MillenniumMachines/UserMods/README.md

# Millennium Machines Community Modifications
Welcome to Millennium Machines Community Mods.

>**Note**: Most recent mods can be found in the Discord channel here: https://discord.com/channels/810620766756012072/1282257966266843136

This repository contains a curated list of modifications for all Millennium Machines. These mods are independently created by members of the community and are not supported in any way by the core Millennium Machines team.
