MillenniumMachines/UserMods/Milo-V1.5/README.md

# Millennium Machines Milo V1.5 Community Modifications

## AramcoPhil
  - [Ballscrew Upgrade](AramcoPhil/Ballscrew%20Upgrade/README.md)
  - [Endmill Organizer](AramcoPhil/Endmill%20Organizer/README.md)
  - [Noga Minicool Mounting Bracket](AramcoPhil/Noga%20Minicool%20Mounting%20Bracket/README.md)

## Bidi533
  - [VFD Mount](Bidi533/VFD%20Mount/README.md)

## Morfesto
  - [Anti-Backlash Nut Mod](Morfesto/Anti-Backlash%20Nut%20Mod/README.md)

## Mr-Rei
  - [80mm Spindle Mount](Mr-Rei/80mm%20Spindle%20Mount)

## seanmccully
  - [Igus Drylin Lead Screw](seanmccully/Igus%20Drylin%20Lead%20Screw/README.md)

## Techmorphic
  - [Parametric Z Plates](Techmorphic/FMJ%20Parametric%20Plates/)

## TheDeeperGrain
  - [Hearts of Iron (HOI)](TheDeeperGrain/Hearts%20of%20Iron%20%28HOI%29/README.md)

## TheUntitledGoose
  - [Ring Light Mod](TheUntitledGoose/Ring%20Light%20Mod/README.md)

## TinkerTailor
  - [80mm Spindle Mount](TinkerTailor/80mm%20Spindle%20Mount)
  - [Duet3 Mount](TinkerTailor/Duet3%20Mount)
  - [PS Bracket plus Cable Channels](TinkerTailor/PS%20Bracket%20plus%20Cable%20Channels/)
  - [SKR3 Mount](TinkerTailor/SKR3%20Mount)
