MillenniumMachines/UserMods/Milo-V1.5/AramcoPhil/Endmill Organizer/README.md

This is a remix of the GEN 2 Modular Drawer System (original Link: https://www.printables.com/model/427214-gen2-parts-drawers )

You'll need at least:

- 1x "Gen 2 Rail Double" from the original design
- 1x "Double Slim Drawer Case" from the original design
- 1x "Endmill ORganizer Drawer" from this directory
