MillenniumMachines/UserMods/Millennium-Milo-V1.5-MODS/Morfesto/Anti-Backlash Nut Mod/README.md

# Morfesto's Anti-Backlash Nut mod

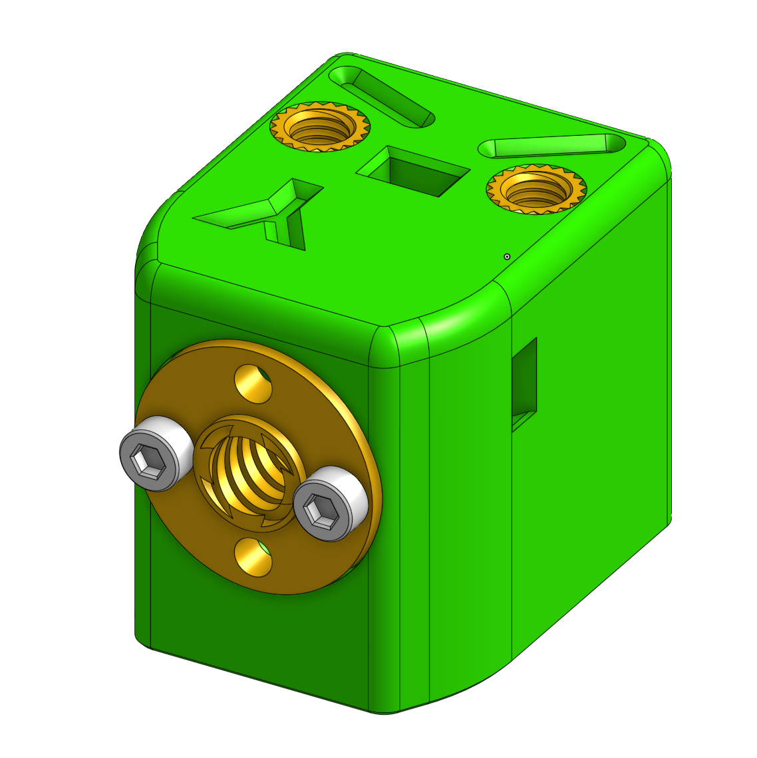
[picture p3: Millennium-Milo-V1.5-MODS/Morfesto/Anti-Backlash Nut Mod/images/iso_view.png]


This mod removes the M3 inserts that tend to bulge into the hole for the anti-backlash nut and replaces them with lock nuts. It also changes the M5 inserts to be inserted from the top so they can't be pulled out as easily.
<table>
    <tr>
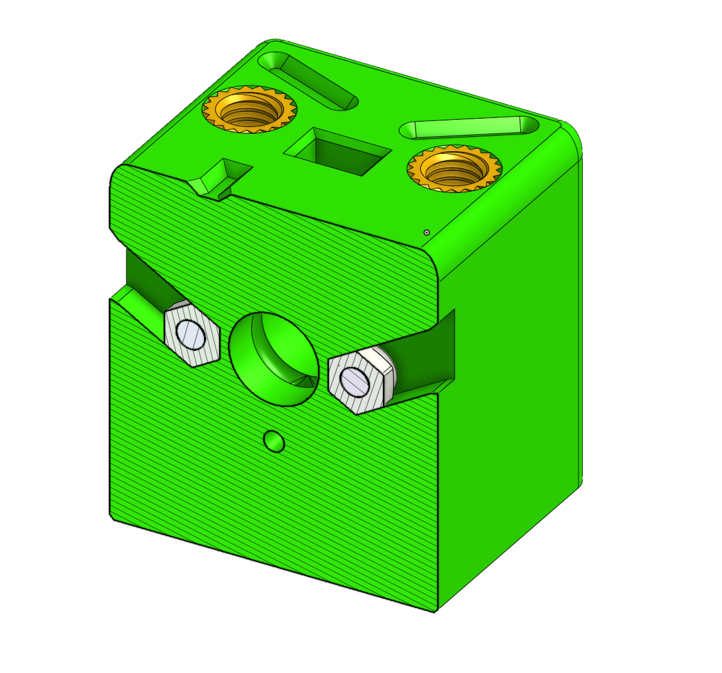
[picture p4: Millennium-Milo-V1.5-MODS/Morfesto/Anti-Backlash Nut Mod/images/cutout_nuts_view.png]
        <td></td>
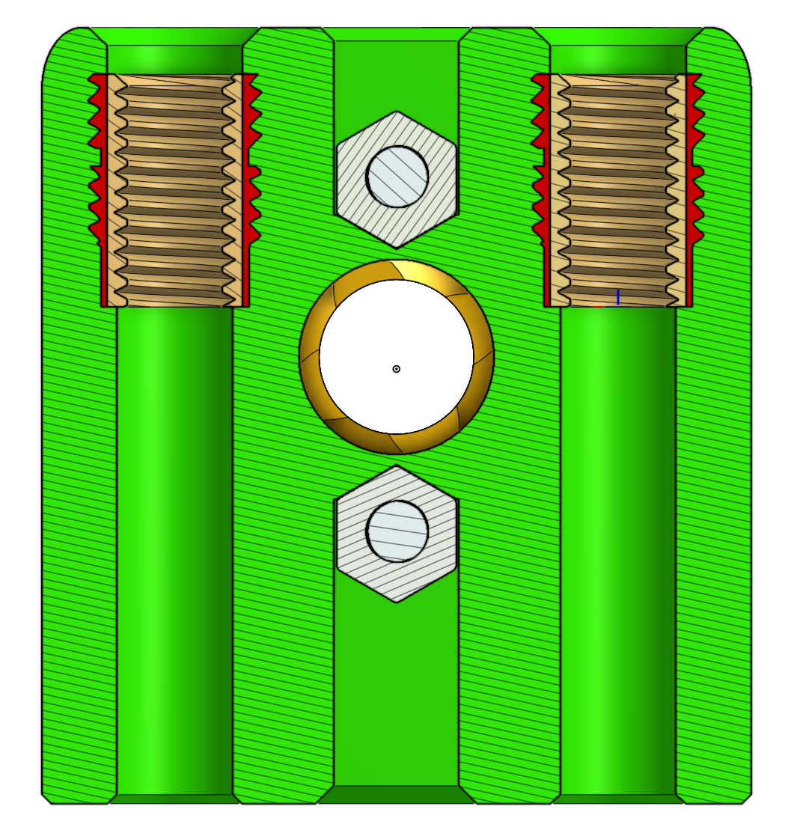
[picture p5: Millennium-Milo-V1.5-MODS/Morfesto/Anti-Backlash Nut Mod/images/cutout_insert_view.png]
        <td></td>
    </tr>
</table>

Lastly it adds a grease port. 

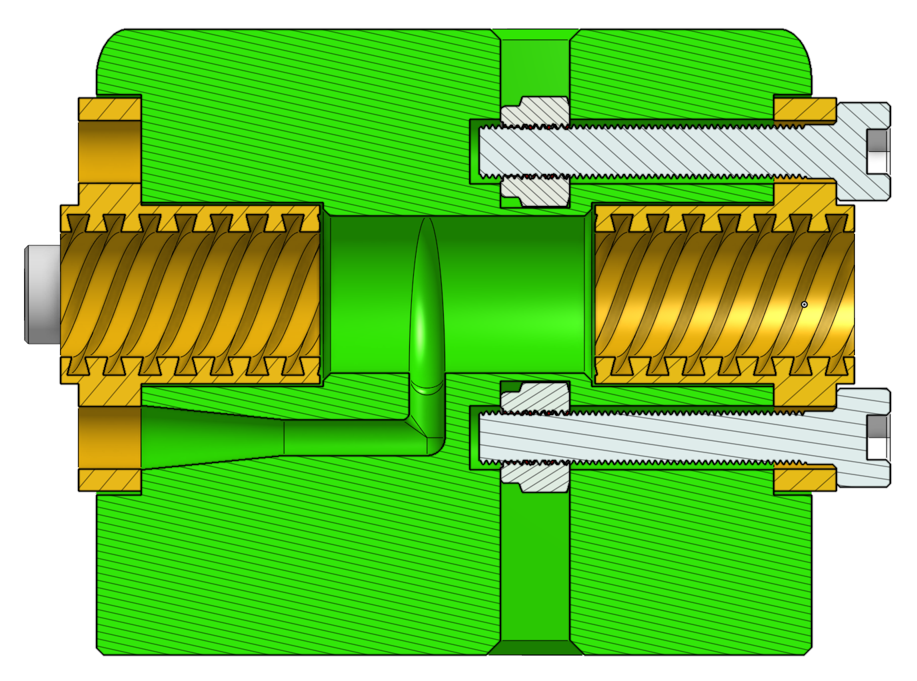
[picture p6: Millennium-Milo-V1.5-MODS/Morfesto/Anti-Backlash Nut Mod/images/cutout_sideview.png]


If you're having a hard time with tolerances or if your hardware is of a different size you can open up this Onshape link and edit the parameters.

[Model in Onshape](https://cad.onshape.com/documents/ad61f8ae473d135feabd2e81/w/a8a77c03487b52f66df65681/e/e948fd554dec3bcaa4e45c56)

# Print Settings

Same as the Milo/LDO guide BUT this mod was done using true to size numbers, you will likely need to use x/y shrinkage compensation for your specific filament.

# BOM
<table>
    <tr>
        <td>Item</td>
        <td>Quantity</td>
    </tr>
    <tr>
        <td>M3x20 BHCS/SHCS</td>
        <td>4x</td>
    </tr>
    <tr>
        <td>M3 nyloc nut</td>
        <td>4x</td>
    </tr>
    <tr>
        <td>M5x10 Heatset insert</td>
        <td>2x</td>
    </tr>
</table>

# How to Use The Grease Port

You need a Luer Lock syringe and a Luer Lock 14Ga blunt tip. Pack your syringe with the recommended grease.

Insert into grease hole as shown below. If your grease is thick it's going to be a hard press but it should go in.
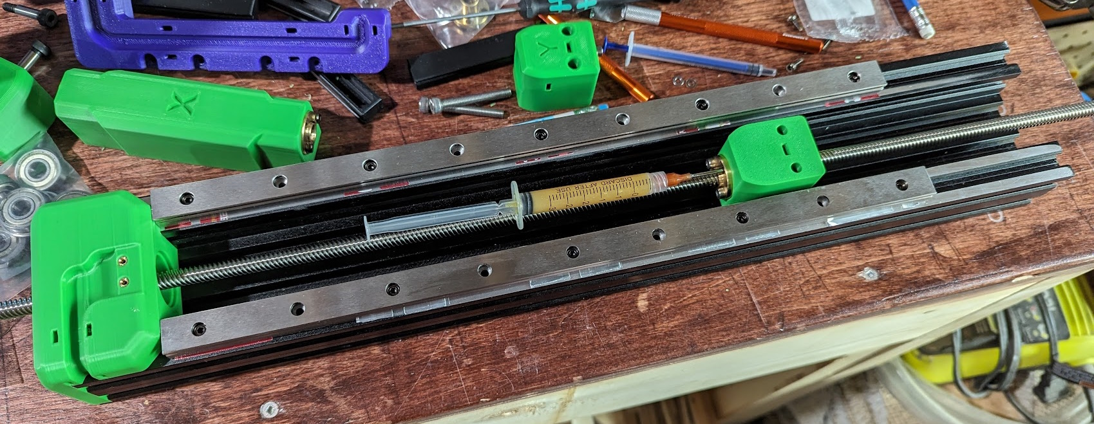
[picture p7: Millennium-Milo-V1.5-MODS/Morfesto/Anti-Backlash Nut Mod/images/greasing_it_up.jpg]


# Coming Soon

I'm gonna start work on the Z Anti-Backlash soon.
