MillenniumMachines/UserMods/Millennium-Milo-V1.5-MODS/TheDeeperGrain/Hearts of Iron (HOI)/README.md

## Dimensions / Required Stock
Front brackets: 2 pieces of 50x20x108mm plate
Rear brackets: 2 pieces of 60x20x108mm plate
