MillenniumMachines/UserMods/Millennium-Milo-V1.5-MODS/AramcoPhil/Noga Minicool Mounting Bracket/Readme.md

This mounts on the Spindlemount instead of the drag chain holder (which i dont use) with an M5x8 Button head or SHCS bolt.

Takes an M4 heatset insert, for an M4x14 SHCS to hold the Minicool to the bracket.

has enough space to run the air line between the Minicool and the spindle mount.
