MillenniumMachines/UserMods/Milo-V1.5/Techmorphic/FMJ Parametric Plates/Z Extrusion Length Calulator.ods

Z Travel | 250 | Stock is 250mm
Clearance | 60 | Stock is 60mm of clearance
Plate thickness | 6.3 | Thickness of the metal
MGN 15 rails | 250 | x2
Extrusion rails | 250 | x1
Main Z | 260 | x2
Small Z C Extrusion | 120 | This stays the same regardless
Fastener | 10.3 | Use M5 washer if a bit too long
Z lead screw | 300 | Minimum length
