MillenniumMachines/UserMods/Millennium-Milo-V1.5-MODS/AramcoPhil/Endmill Organizer/Endmill_organizer_drawer.stl

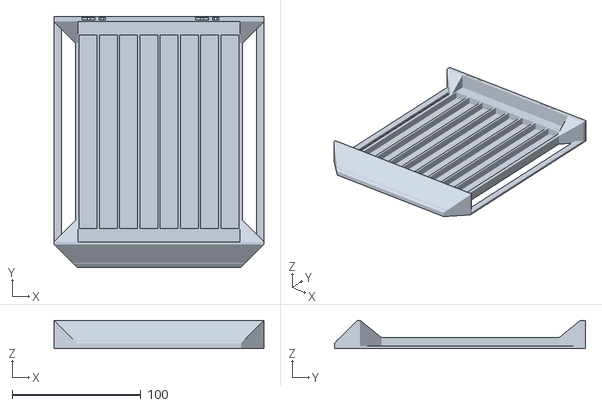
[picture p10: CAD file, 2023-10-01]
Millennium-Milo-V1.5-MODS/AramcoPhil/Endmill Organizer/Endmill_organizer_drawer.stl
163.0 x 195.0 x 22.0
