MillenniumMachines/UserMods/Millennium-Milo-V1.5-MODS/AramcoPhil/Noga Minicool Mounting Bracket/Noga_holder.stl

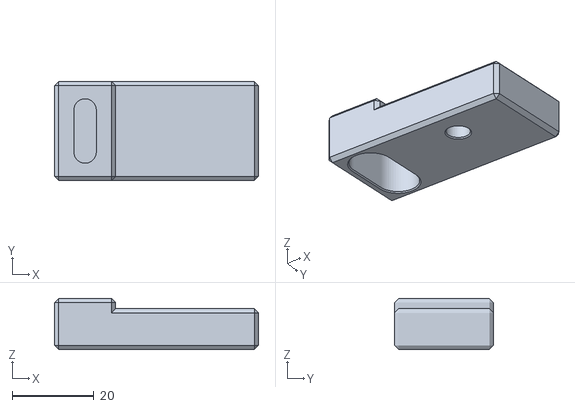
[picture p11: CAD file, 2023-10-01]
Millennium-Milo-V1.5-MODS/AramcoPhil/Noga Minicool Mounting Bracket/Noga_holder.stl
50.0 x 24.3 x 12.5
