MillenniumMachines/UserMods/Millennium-Milo-V1.5-MODS/Bidi533/Bidi533-vfd-mount/vfd_mount_yl_620_a v1.step

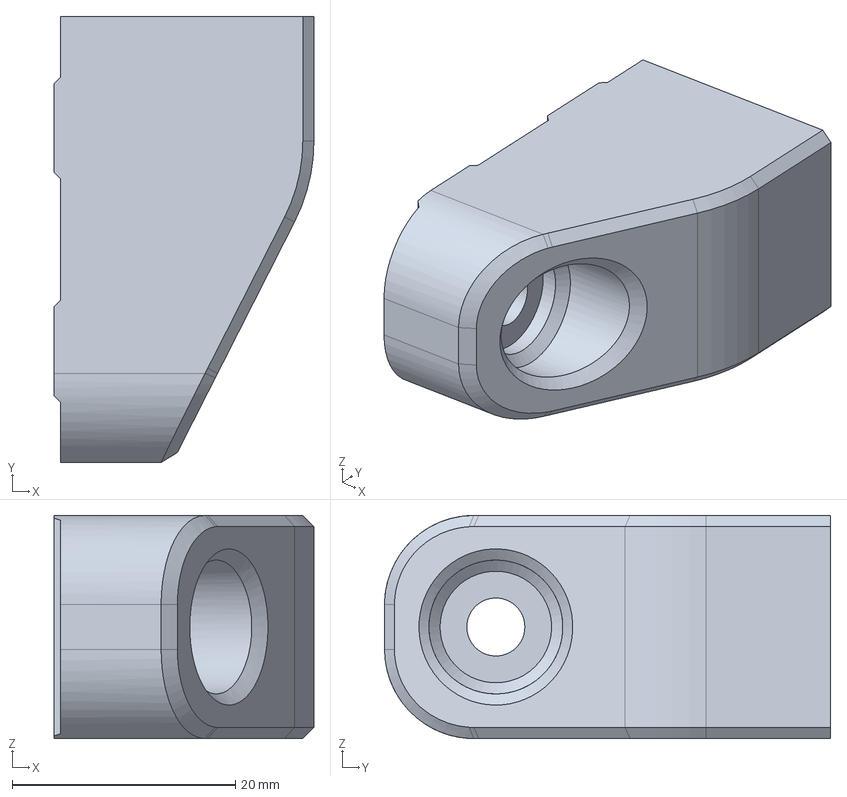
[picture p12: CAD file, 2022-10-31]
Millennium-Milo-V1.5-MODS/Bidi533/Bidi533-vfd-mount/vfd_mount_yl_620_a v1.step
23.3 x 40.0 x 20.0 mm
