MillenniumMachines/UserMods/Millennium-Milo-V1.5-MODS/Mr-Rei/Mr-Reis-80mm-Spindle-mount/80mm_v1.1.step

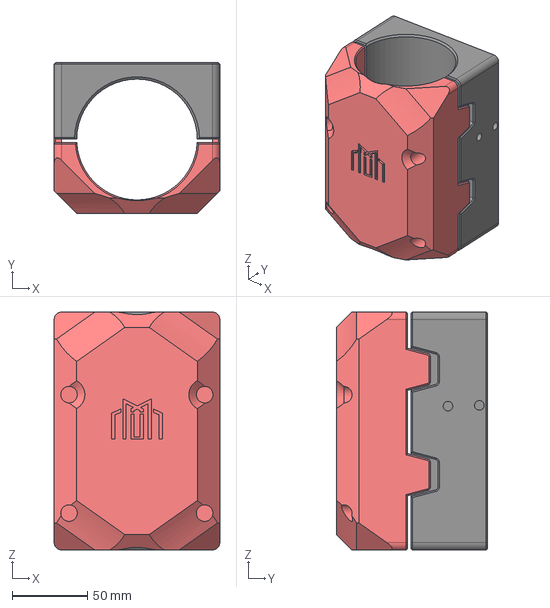
[picture p13: CAD file, 2022-11-30]
Millennium-Milo-V1.5-MODS/Mr-Rei/Mr-Reis-80mm-Spindle-mount/80mm_v1.1.step
110.0 x 100.4 x 158.0 mm
SMH 80mm part B
SMH 80mm part A (1)
