MillenniumMachines/UserMods/Millennium-Milo-V1.5-MODS/TheDeeperGrain/Hearts of Iron (HOI)/Iron heart MOD (deepergrain) v4.step

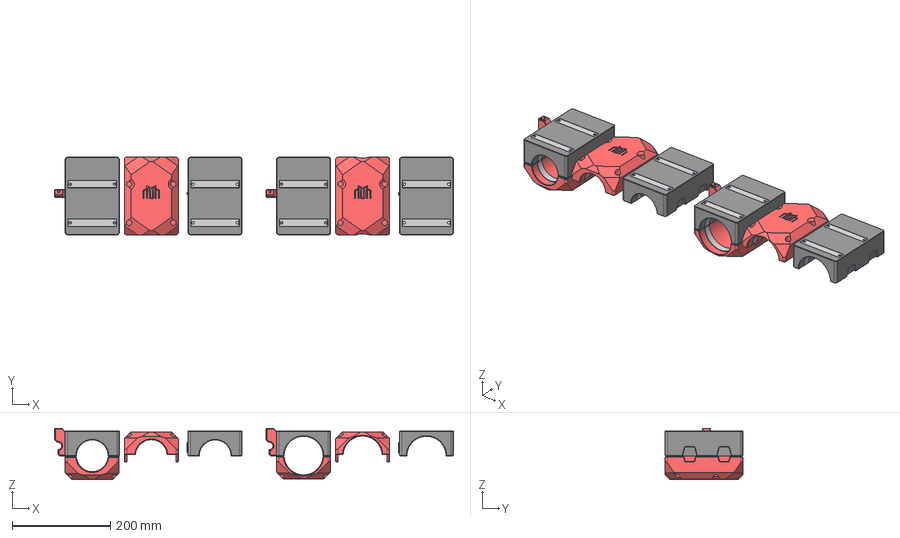
[picture p14: CAD file, 2023-12-06]
Millennium-Milo-V1.5-MODS/TheDeeperGrain/Hearts of Iron (HOI)/Iron heart MOD (deepergrain) v4.step
811.9 x 158.0 x 104.5 mm
Burly Z cable chain mount (1)
Rear mount 80mm (2) x 2
Rear mount 80mm (1) (1) x 2
Rear Shroud 80mm (1) x 2
Front mount 80mm (1) x 2
Front mount 80mm (1) x 2
Front shroud 80mm (1)
Front shroud 80mm (1) (1)
Front mount 80mm (1) (1)
Front mount 80mm (1) (1)
Front shroud 80mm (2)
Front mount 80mm (2)
Front mount 80mm (2)
Rear mount 80mm (3)
Rear mount 80mm (1) (2)
Rear Shroud 80mm (2)
Rear mount 80mm
Rear mount 80mm (1)
Rear Shroud 80mm
Burly Z cable chain mount
Front shroud 80mm
Front mount 80mm x 2
