MillenniumMachines/UserMods/Millennium-Milo-V1.5-MODS/TheUntitledGoose/RingLightMod/STLs and Mechanicals/HOI 65mm Rear Spindle Mount.3mf

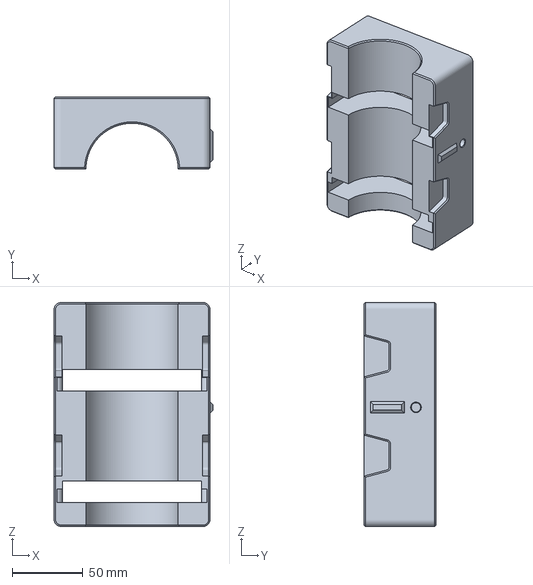
[picture p15: CAD file, 2024-07-12]
Millennium-Milo-V1.5-MODS/TheUntitledGoose/RingLightMod/STLs and Mechanicals/HOI 65mm Rear Spindle Mount.3mf
112.0 x 50.9 x 158.0 mm
