MillenniumMachines/UserMods/Millennium-Milo-V1.5-MODS/TinkerTailor/TinkerTailor-80mm-Spindle-mount/80mm_Spindle_Front.stl

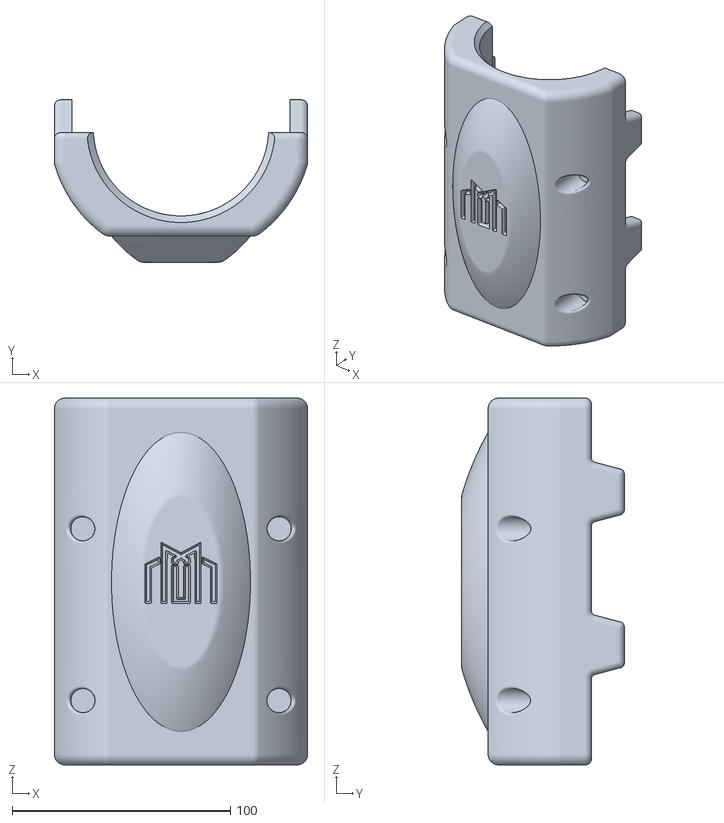
[picture p16: CAD file, 2022-11-24]
Millennium-Milo-V1.5-MODS/TinkerTailor/TinkerTailor-80mm-Spindle-mount/80mm_Spindle_Front.stl
116.0 x 74.4 x 168.0
