MillenniumMachines/UserMods/Millennium-Milo-V1.5-MODS/TinkerTailor/Tinkertailor-PS-Bracket-Plus-Cable-Channels/PS_Bracket_plus_Cable_Mgmt.stl

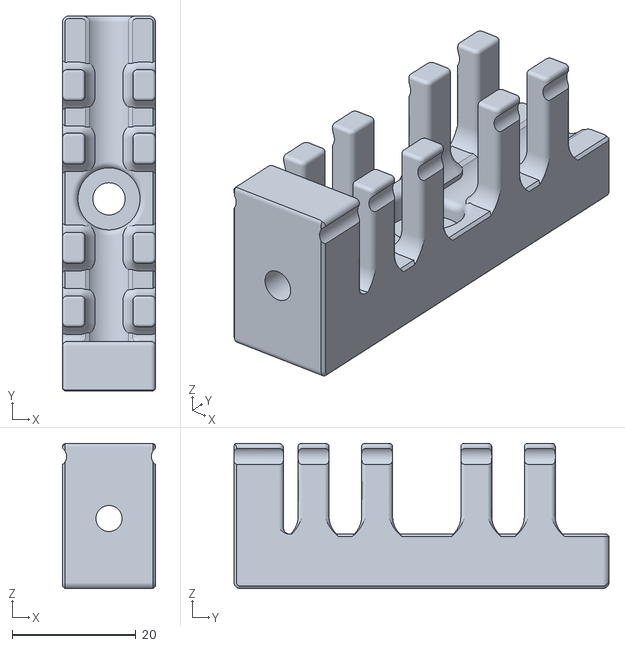
[picture p17: CAD file, 2022-11-30]
Millennium-Milo-V1.5-MODS/TinkerTailor/Tinkertailor-PS-Bracket-Plus-Cable-Channels/PS_Bracket_plus_Cable_Mgmt.stl
15.0 x 60.5 x 23.4
