MillenniumMachines/UserMods/Millennium-Milo-V1.5-MODS/TinkerTailor/TinkerTailor-SKR3-Mount/SKR3_Mounting_Plate.stl

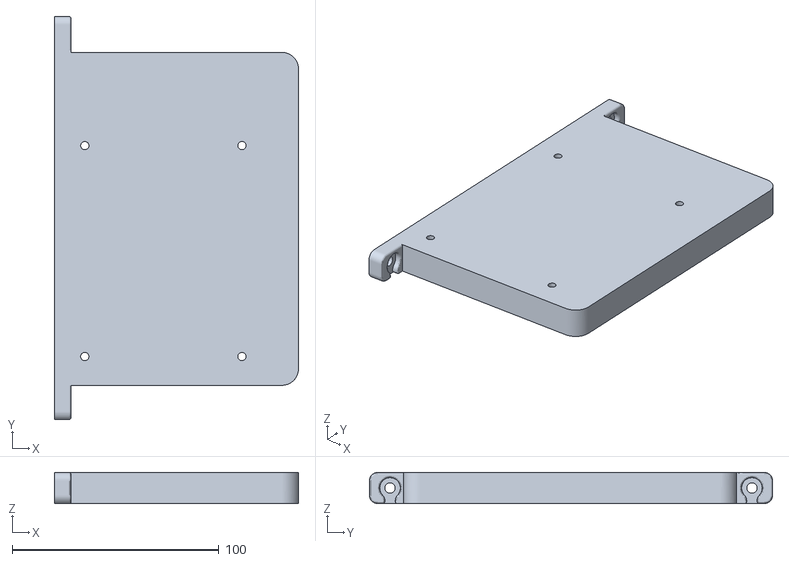
[picture p18: CAD file, 2022-11-30]
Millennium-Milo-V1.5-MODS/TinkerTailor/TinkerTailor-SKR3-Mount/SKR3_Mounting_Plate.stl
118.0 x 195.0 x 15.0
