MillenniumMachines/UserMods/Milo-V1.5/Mr-Rei/80mm Spindle Mount/80mm Spindle Mount - Back - V1.1.stl

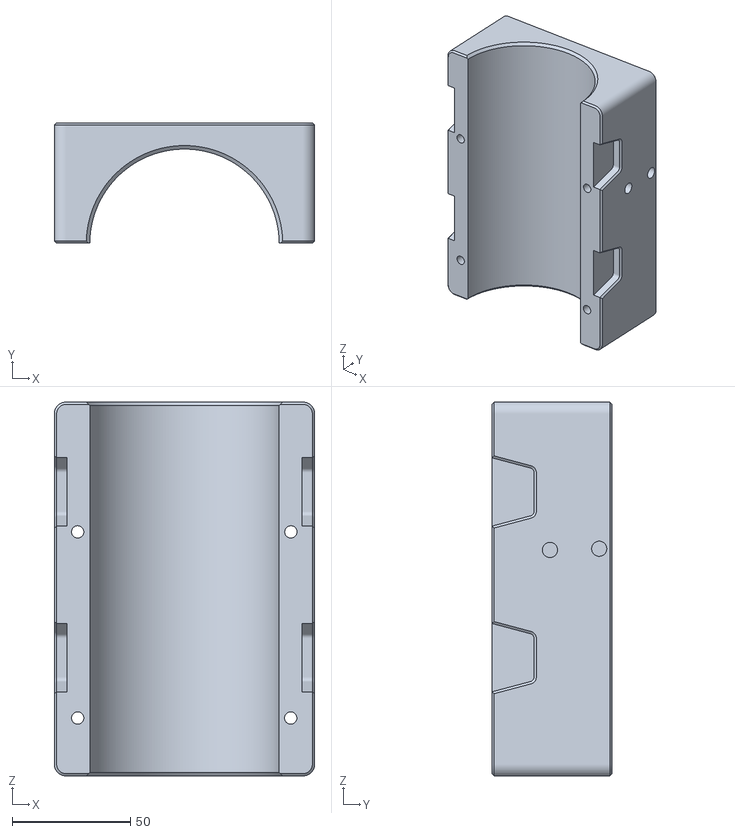
[picture p19: CAD file, 2022-10-20]
Milo-V1.5/Mr-Rei/80mm Spindle Mount/80mm Spindle Mount - Back - V1.1.stl
110.0 x 50.9 x 158.0
