MillenniumMachines/UserMods/Milo-V1.5/TheUntitledGoose/Ring Light Mod/STLs and Mechanicals/[a] Spindle Mount 80mm Part A x1 - Heatset Usermod.3mf

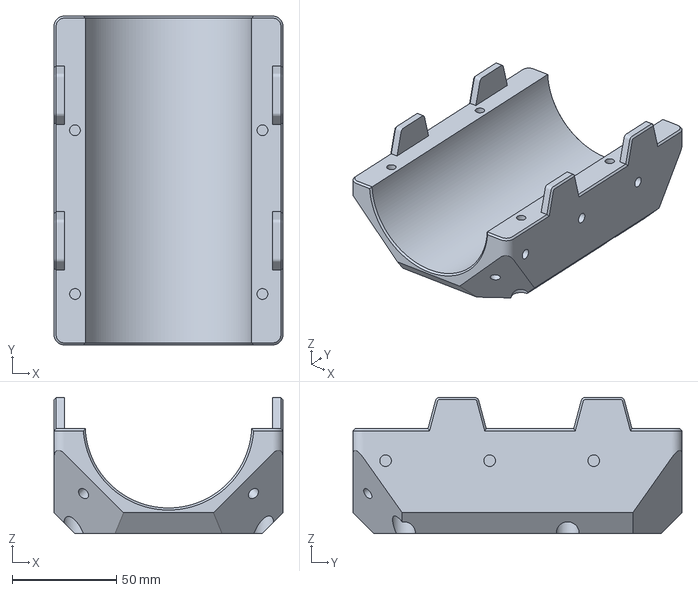
[picture p20: CAD file, 2024-02-16]
Milo-V1.5/TheUntitledGoose/Ring Light Mod/STLs and Mechanicals/[a] Spindle Mount 80mm Part A x1 - Heatset Usermod.3mf
110.0 x 158.0 x 65.4 mm
