MillenniumMachines/UserMods/Milo-V1.5/TinkerTailor/80mm Spindle Mount/80mm Spindle Mount - Back.stl

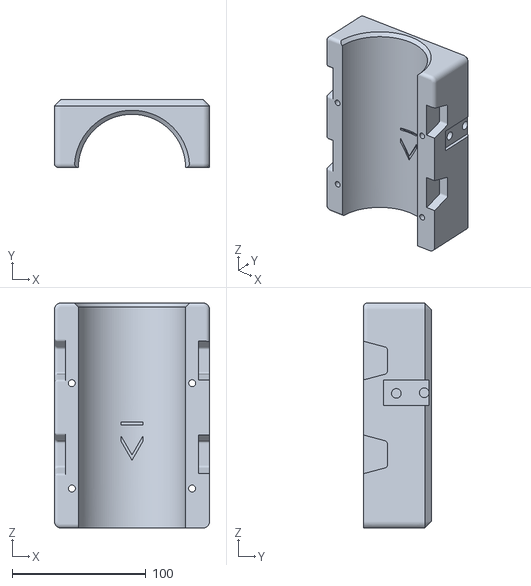
[picture p21: CAD file, 2022-11-24]
Milo-V1.5/TinkerTailor/80mm Spindle Mount/80mm Spindle Mount - Back.stl
116.0 x 50.9 x 168.0
