MillenniumMachines/UserMods/Milo-V1.5/TinkerTailor/Duet3 Mount/Duet3 Mounting Plate.stl

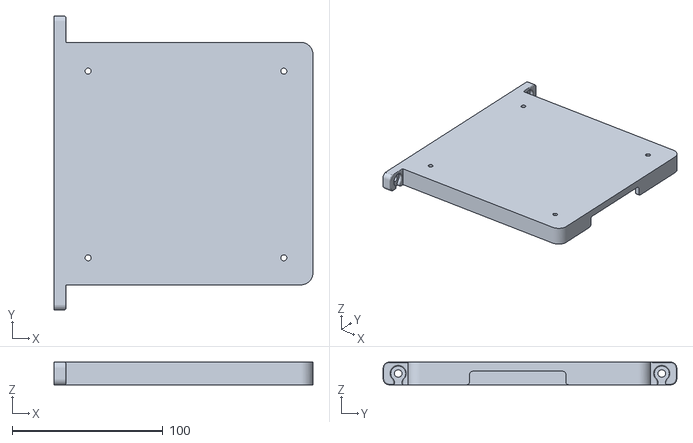
[picture p22: CAD file, 2022-11-30]
Milo-V1.5/TinkerTailor/Duet3 Mount/Duet3 Mounting Plate.stl
172.0 x 195.0 x 15.0
