MillenniumMachines/UserMods/Milo-V1.5/TinkerTailor/PS Bracket plus Cable Channels/PS Bracket and Cable Mgmt Cap.stl

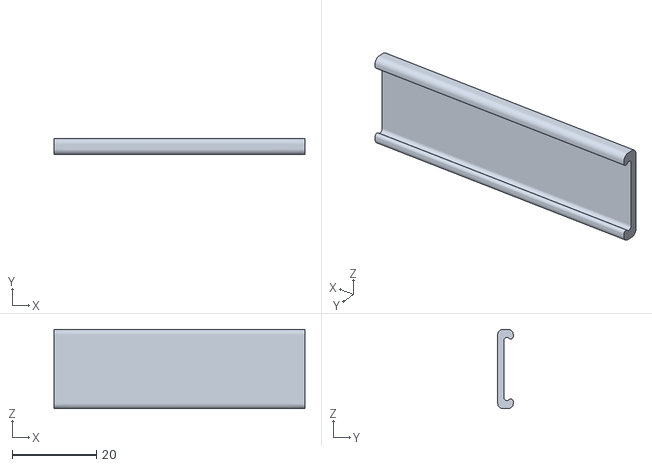
[picture p23: CAD file, 2022-11-30]
Milo-V1.5/TinkerTailor/PS Bracket plus Cable Channels/PS Bracket and Cable Mgmt Cap.stl
59.5 x 3.70 x 18.8
