MillenniumMachines/UserMods/Milo-V1.5/TheUntitledGoose/Ring Light Mod/STLs and Mechanicals/PCB Formfactor.3mf

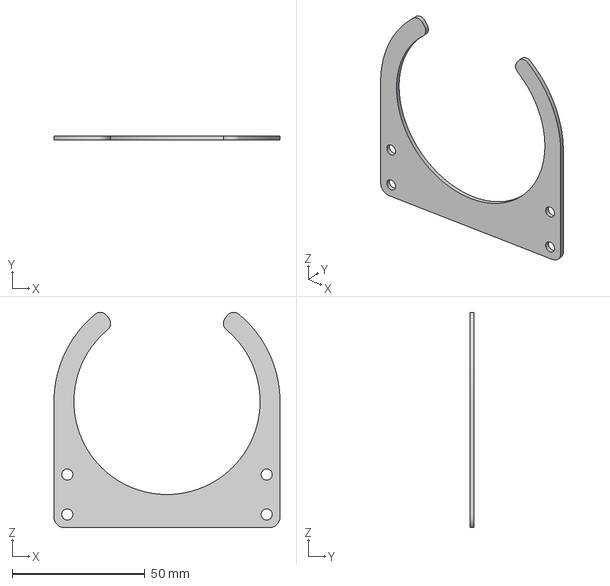
[picture p26: CAD file, 2024-02-16]
Milo-V1.5/TheUntitledGoose/Ring Light Mod/STLs and Mechanicals/PCB Formfactor.3mf
85.0 x 1.60 x 81.0 mm
