MillenniumMachines/UserMods/Millennium-Milo-V1.5-MODS/TheUntitledGoose/RingLightMod/STLs and Mechanicals/SMH 80mm part B Modified.3mf

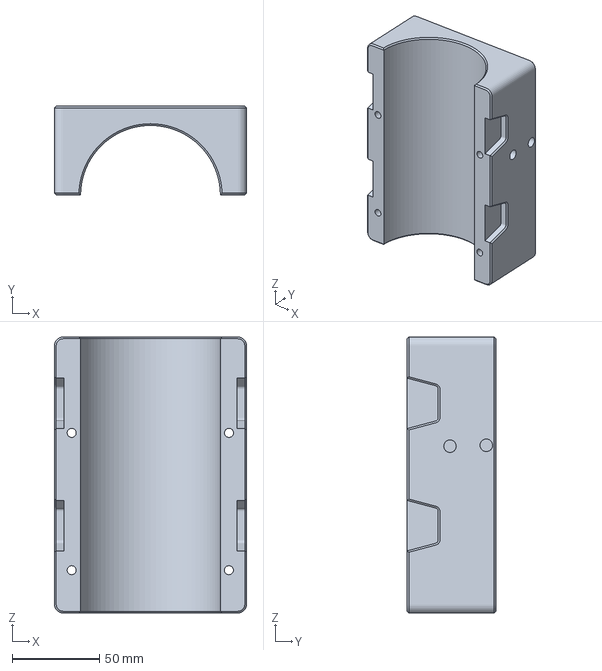
[picture p27: CAD file, 2024-02-16]
Millennium-Milo-V1.5-MODS/TheUntitledGoose/RingLightMod/STLs and Mechanicals/SMH 80mm part B Modified.3mf
110.0 x 50.9 x 158.0 mm
