MillenniumMachines/UserMods/Millennium-Milo-V1.5-MODS/TheUntitledGoose/RingLightMod/STLs and Mechanicals/LogoDXF.dxf

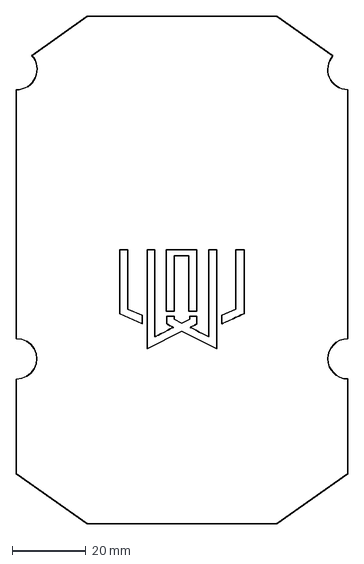
[picture p28: CAD file, 2024-02-16]
Millennium-Milo-V1.5-MODS/TheUntitledGoose/RingLightMod/STLs and Mechanicals/LogoDXF.dxf
90.0 x 138.0 mm
