MillenniumMachines/UserMods/Millennium-Milo-V1.5-MODS/TheUntitledGoose/RingLightMod/STLs and Mechanicals/PCBForMilo.dxf

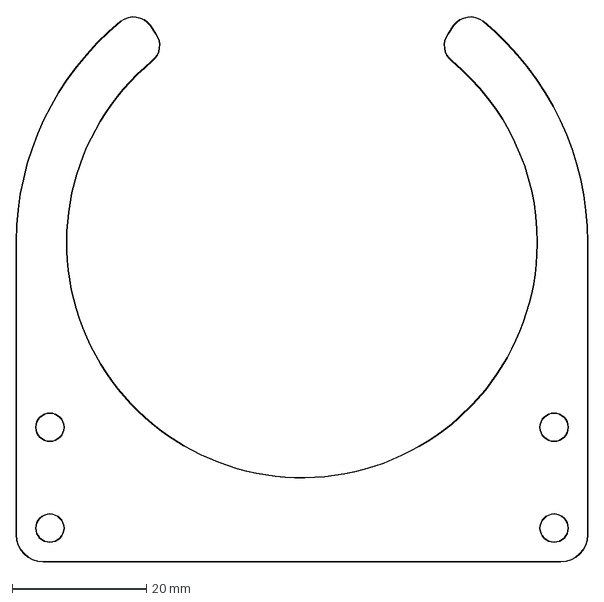
[picture p29: CAD file, 2024-02-16]
Millennium-Milo-V1.5-MODS/TheUntitledGoose/RingLightMod/STLs and Mechanicals/PCBForMilo.dxf
85.0 x 81.1 mm
