MillenniumMachines/UserMods/(list of files, cad)

Other CAD files:
Milo-V1.5/Bidi533/VFD Mount/VFD Mount.3mf
Milo-V1.5/TheDeeperGrain/Hearts of Iron (HOI)/Iron heart MOD (deepergrain).step
Millennium-Milo-V1.5-MODS/AramcoPhil/Ballscrew upgrade/2x_motorspacer.stl
Millennium-Milo-V1.5-MODS/AramcoPhil/Ballscrew upgrade/X_Bearingblock.stl
Millennium-Milo-V1.5-MODS/AramcoPhil/Ballscrew upgrade/X_Motorblock.stl
Millennium-Milo-V1.5-MODS/AramcoPhil/Ballscrew upgrade/X_Nutholder.stl
Millennium-Milo-V1.5-MODS/AramcoPhil/Ballscrew upgrade/Y_Bearingblock.stl
Millennium-Milo-V1.5-MODS/Morfesto/Anti-Backlash Nut Mod/CAD/Y Axis Anti Backlash Nut x1_LDO_FIXED - Nyloc Nut.step
Millennium-Milo-V1.5-MODS/Morfesto/Anti-Backlash Nut Mod/STLs/Y Axis Anti Backlash Nut x1_LDO_FIXED - Nyloc V3.stl
Millennium-Milo-V1.5-MODS/Techmorphic/Techmorphic-FMJ-para-plates/Parametric_z_plates_v9.f3d
Millennium-Milo-V1.5-MODS/seanmccully/IgusDrylinLeadScrew/Z Axis AntiBacklsh Nut.f3d
Milo-V1.5/AramcoPhil/Ballscrew Upgrade/Y Motor Block.stl
Milo-V1.5/AramcoPhil/Ballscrew Upgrade/Y Nut Holder.stl
