MillenniumMachines/UserMods/(threads)

Thread 12 (2024-02-03):

Thin wall on HOI mod

jmsweng, 2024-02-03:
Thickness between wall and internal corner is extremely thin (0.068 mm) where the bottom metal bracket inserts and creates a small hole when sliced:
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

Chamfer angles were adjusted slightly to increase the thickness of that wall so that it prints properly:
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

The small corner that hangs down and causes a print artifact was also removed:
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

Comparison of the modified part and original part (left is new, right is original):
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

Part now prints correctly without artifacts with recommended settings and with a 0.6mm nozzle and either a 0.2 and 0.28 mm layer height.

It may be a good idea to print with some supports around the hole as pictured below, if printer being used bridges poorly:
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

Step files for the 65mm and 85mm spindle front cover are attached.
