MillenniumMachines/UserMods/Milo-V1.5/TheUntitledGoose/Ring Light Mod/Gerbers/KiCad/Milo_RingLight.kicad_pcb

## KiCad design Milo-V1.5/TheUntitledGoose/Ring Light Mod/Gerbers/KiCad/Milo_RingLight.kicad_pcb (2024-02-16)

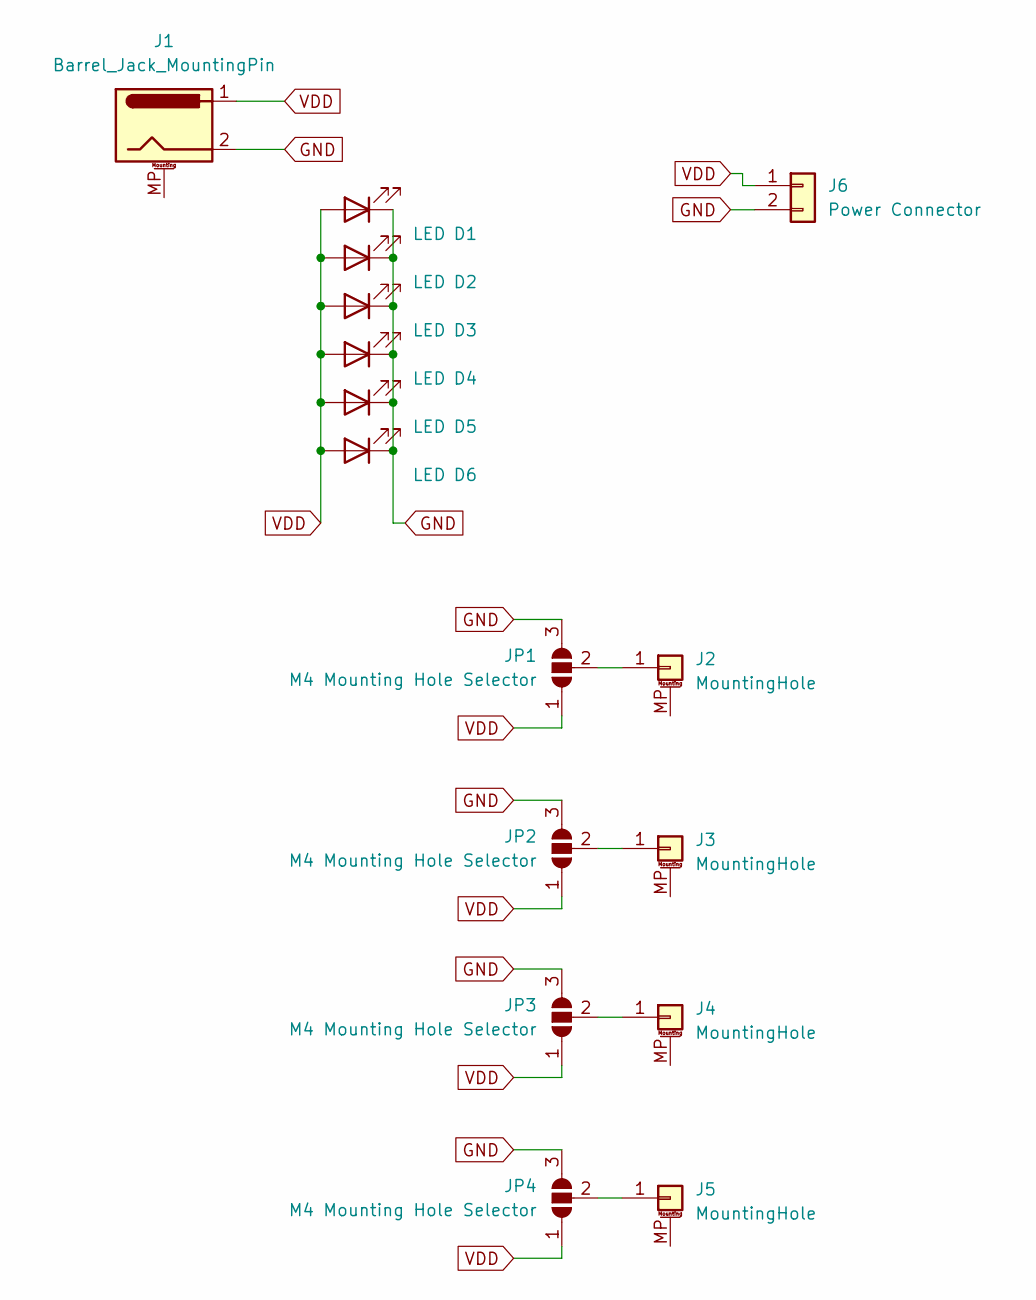
[picture p30: schematic Milo_RingLight.kicad_sch]

Parts:
D1, D2, D3, D4, D5, D6: LED; LED_Yuji_5730
J1: Barrel_Jack_MountingPin; BarrelJack_Wuerth_6941xx301002
J2, J3, J4, J5: MountingHole; MountingHole_4.3mm_M4_Pad_Via
J6: Power Connector; JST_EH_B2B-EH-A_1x02_P2.50mm_Vertical
JP1, JP2, JP3, JP4: M4 Mounting Hole Selector; SolderJumper-3_P1.3mm_Open_RoundedPad1.0x1.5mm

Connections:
GND: D1.1 (K), D2.1 (K), D3.1 (K), D4.1 (K), D5.1 (K), D6.1 (K), J1.2, J6.2, JP1.3 (B), JP2.3 (B), JP3.3 (B), JP4.3 (B)
unnamed: J2.1, JP1.2 (C)
unnamed: J3.1, JP2.2 (C)
unnamed: J4.1, JP3.2 (C)
unnamed: J5.1, JP4.2 (C)
VDD: D1.2 (A), D2.2 (A), D3.2 (A), D4.2 (A), D5.2 (A), D6.2 (A), J1.1, J6.1, JP1.1 (A), JP2.1 (A), JP3.1 (A), JP4.1 (A)

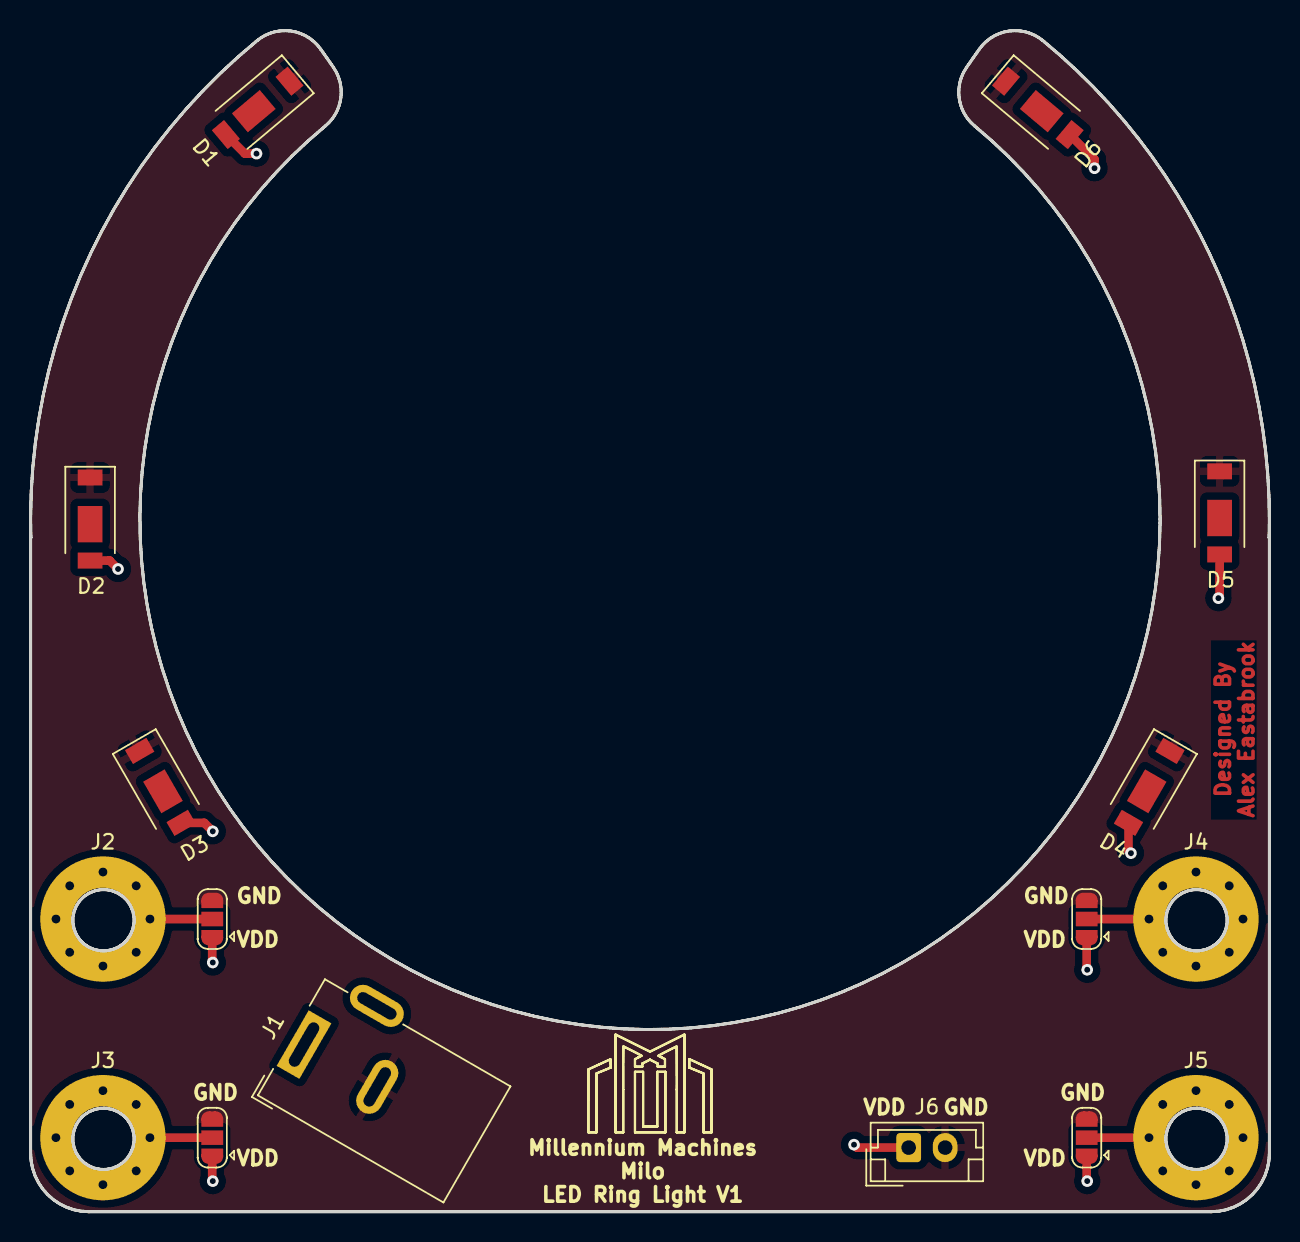
[picture p31: board Milo_RingLight.kicad_pcb from above]

Board: 2 copper layers, 85.0 x 81.0 mm, 16 parts (0 on the bottom side), 6 nets.
