MillenniumMachines/UserMods/(commit log)

2022-09-24 Create Millennium-Milo-V1.5-MODS
2022-10-31 added files
    added files
    [Body21.3mf, vfd_mount_yl_620_a v1.step]
2022-11-24 Added tinker tailor 80mm spindle mount
    [80mm_Spindle_Back.stl, 80mm_Spindle_Front.stl]
2022-11-30 Added some new mods and re-organised folders by contributor
    [80_back_v1.1.stl, 80_front_v1.1.stl, 80mm_Spindle_Back.stl, 80mm_Spindle_Front.stl, 80mm_v1.1.step, Body21.3mf, Duet_3_Mounting_Plate.stl, Parametric_z_plates_v9.f3d]
2022-11-30 Added TinkerTailor PS-Bracket-plus
    [PS_Bracket_and_Cable_Mgmt_Cap.stl, PS_Bracket_plus_Cable_Mgmt.stl]
2023-10-01 Endmill Organizer for the GEN2 Drawer System
    A remix of a drawer system for the GEN2 Drawers (original Model here: https://www.printables.com/model/427214-gen2-parts-drawers/files )
    [Endmill_organizer_drawer.stl]
2023-10-01 Added an Endmill Organizer Drawer for the "GEN2 Drawer System"
    Remix for an Endmill organizer for the GEN2 Drawer System (Original parts https://www.printables.com/model/427214-gen2-parts-drawers/files )
    [Endmill_organizer_drawer.stl]
2023-10-01 Added a Mounting Bracket for a Noga Mini Cool
    [Noga_holder.stl]
2023-11-20 Added Ballscrew Update Files
    [2x_motorspacer.stl, X_Bearingblock.stl, X_Motorblock.stl, X_Nutholder.stl, Y_Bearingblock.stl, Y_Nutholder.stl, Y_motorblock.stl]
2023-11-22 Reorganise user mods for consistency
    Same organisational changes as made in the other repos.
    Spelling fixes, more consistent file naming and READMEs.
    [80mm Spindle Mount - Back - V1.1.stl, 80mm Spindle Mount - Back.stl, 80mm Spindle Mount - Front - V1.1.stl, 80mm Spindle Mount - Front.stl, 80mm Spindle Mount - V1.1.step, Duet3 Mounting Plate.stl, Endmill Organizer Drawer.stl, Motor Spacer x2.stl]
2023-12-06 Create Iron heart MOD (deepergrain) v4.step
    [Iron heart MOD (deepergrain) v4.step]
2023-12-07 Fixed issues with CAD names
    [Iron heart MOD (deepergrain).step]
2024-02-16 Make Release - V1 of Ring light and Heat set Mod for the 80mm Spindle.
    Was on the Discord and Bazil｜M022 - Asked for some info about what I'd done.
    Wanted to get the design files off my PC and into the cloud before I forget the context.
    Opening a PR Next :)
    [LogoDXF.dxf, Milo_RingLight.kicad_pcb, Milo_RingLight.kicad_sch, PCB Formfactor.3mf, PCBForMilo.dxf, SMH 80mm part B Modified.3mf, [a] Spindle Mount 80mm Part A x1 - Heatset Usermod.3mf]
2024-02-16 Added HOI Spindle Mounts
    Added HOI Versions of the Spindle Mount with PCB mounting locations
    [HOI 65mm Rear Spindle Mount.3mf, HOI 80mm Rear Spindle Mount.3mf]
2024-03-28 Update Iron heart MOD (deepergrain).step
    [Iron heart MOD (deepergrain).step]
2026-10-30 Added note on current notes on Discord
